PepeTheFroggie/SolarBatControl/README.md

# SolarBatControl
A relay battery controller runnning on a cheapo esp8266 relay board using Shelly3EM to measure grid power and control battery charge/discharge accordingly.

This project need a Shelly 3EM ($110), a batery capable 150W grid tie inverter (Y&H $30) and a 30V 5A DC charger ($50). It runs on a esp8266 4-relay board ($8). And you need a battery, i use 24V 30ah LiFePo4.

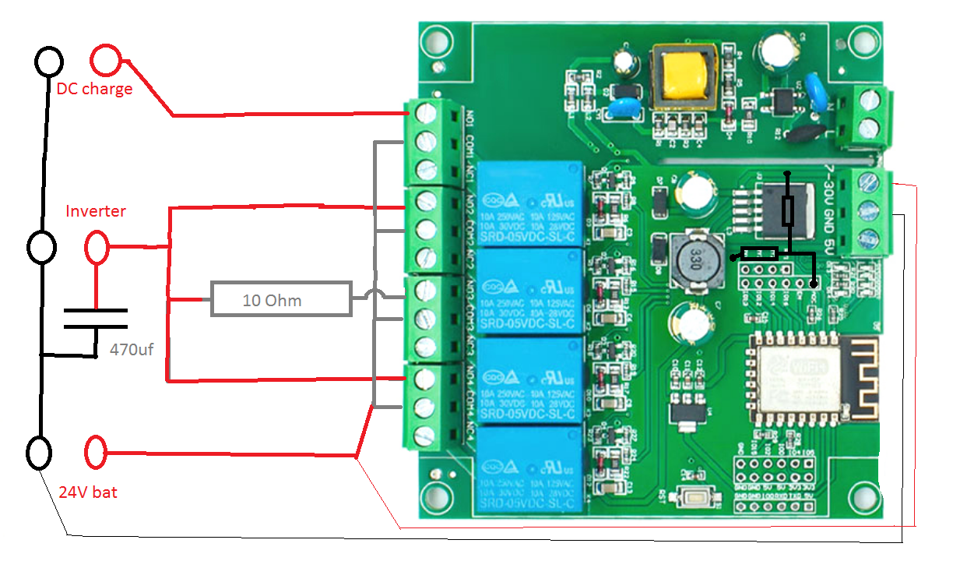
[picture p1: schematic.png]
This way


The 2 black resistors are a voltage divider to measure battery voltage. They transform 30V into 1V, 30k and 1k if i remember correctly, and there is a 100uf C over the adc line which i forgot to draw.
The 10 ohm resistor pre-charges the inverter condensers. Not optional. The two discharge relais are in parallel because the current can exceed the relais specs.
The battery can be charged with a solar charger. Connect directly to batery not over DC-charger pin.

Function:
The device produces 150W or consumes 150W in order to flatten out the energy consumption / production.

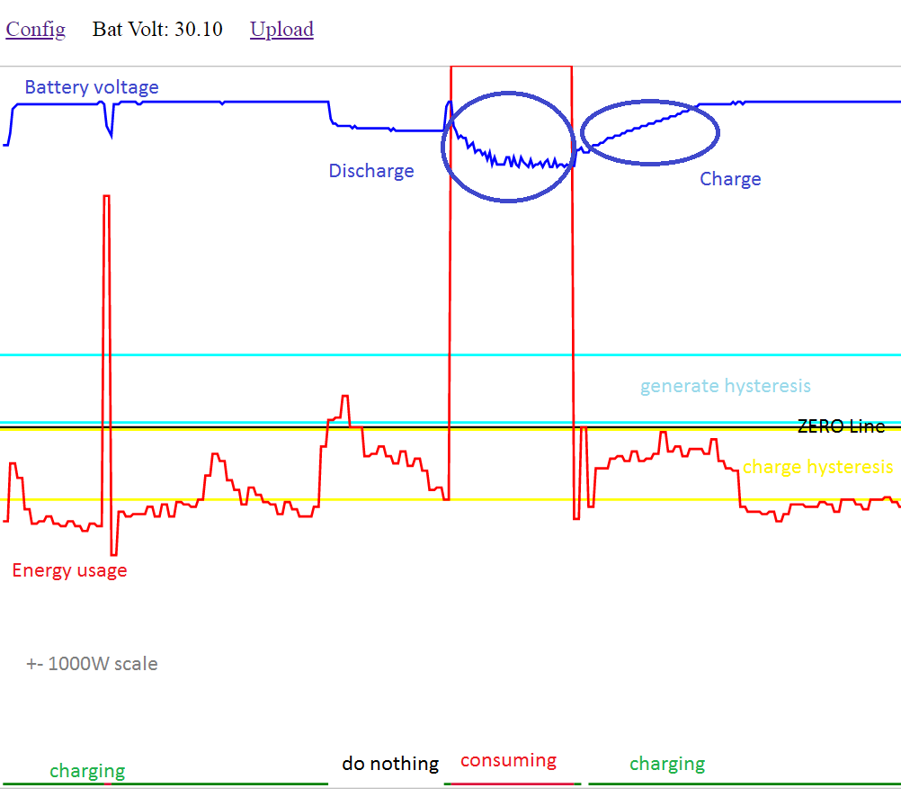
[picture p2: Untitled.png]
Function


If shelly reports more than 200W solar excess the DC charger is activated. The charger is switched off if less than 10W excess solar.
If shelly reports more than 200W consumption the inverter is switched on. Switched off at less than 10W consumption, or battery low. Those levels are settable in "config".

The communication relay - shelly is WiFi. The relay board has its own webserver showing the graph of battery voltage and energy consumption.

This is how it handles my airfryer:
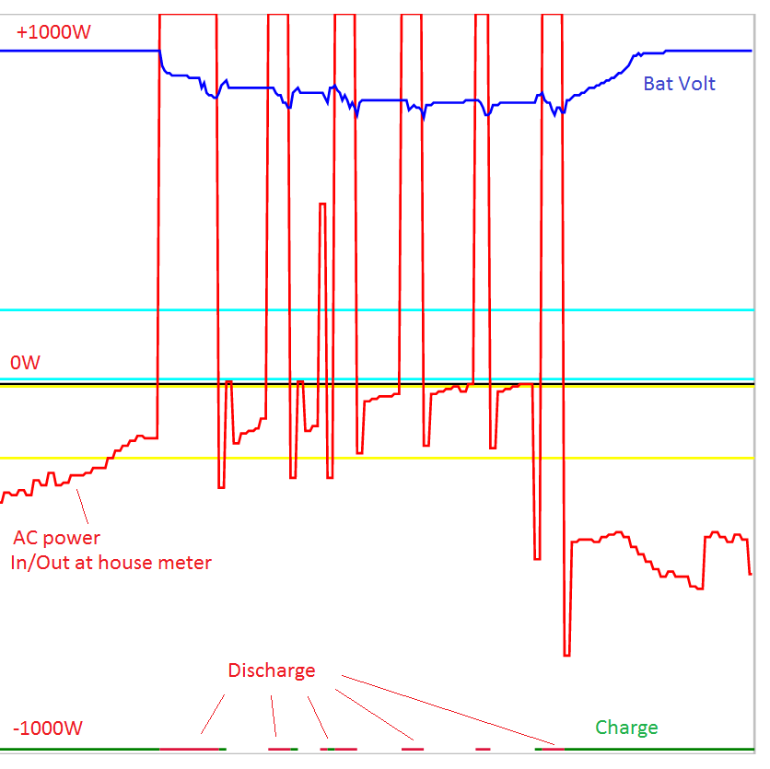
[picture p3: airfryer.png]
airfryer


This is the settings page: 
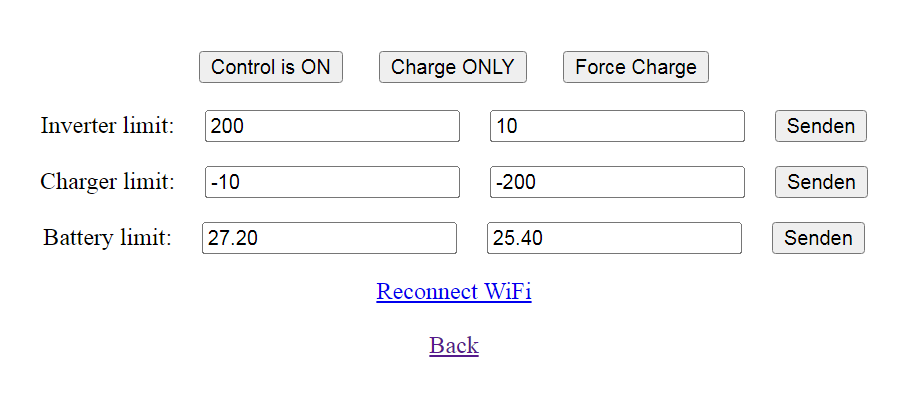
[picture p4: Unti232tled.png]
settings
